AXKuhta/stm32_ad9910/README.md

# stm32_ad9910

A rack-mounted signal generator built around an AD9910 evaluation board and a NUCLEO-F746ZG

siggen_outside_gamma2
siggen_insides_gamma2
