AXKuhta/stm32_ad9910/Docs/box.jpg

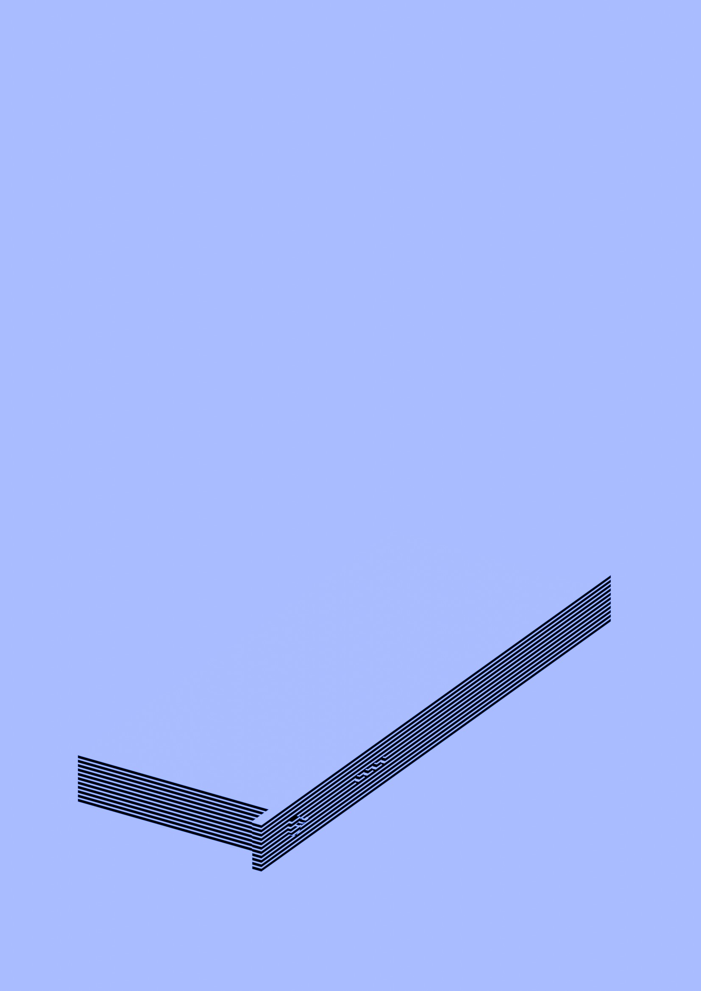
Docs/box.jpg
