AXKuhta/stm32_ad9910/(list of files, cad)

Other CAD files:
Docs/box.blend
