AXKuhta/stm32_ad9910/Docs/Images/signal_generator.drawio.pdf

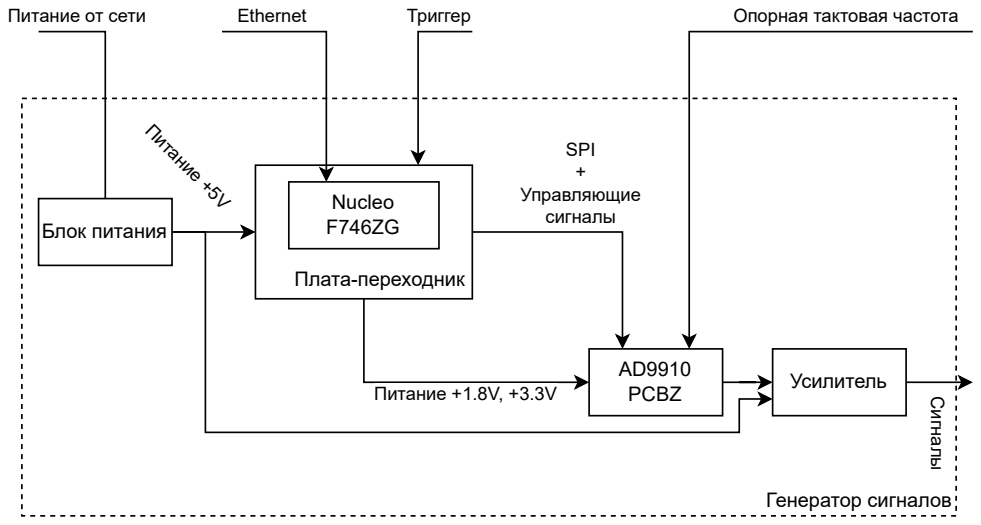
[picture p2: page 1]
Генератор сигналов; AD9910 PCBZ; Питание +5V; Триггер; Плата-переходник; SPI + Управляющие сигналы; Ethernet; Nucleo F746ZG; Питание +1.8V, +3.3V; Блок питания; Сигналы; Усилитель

Питание от сети

Опорная тактовая частота
