AXKuhta/stm32_ad9910/Docs/Images/physical_interfaces.drawio.pdf

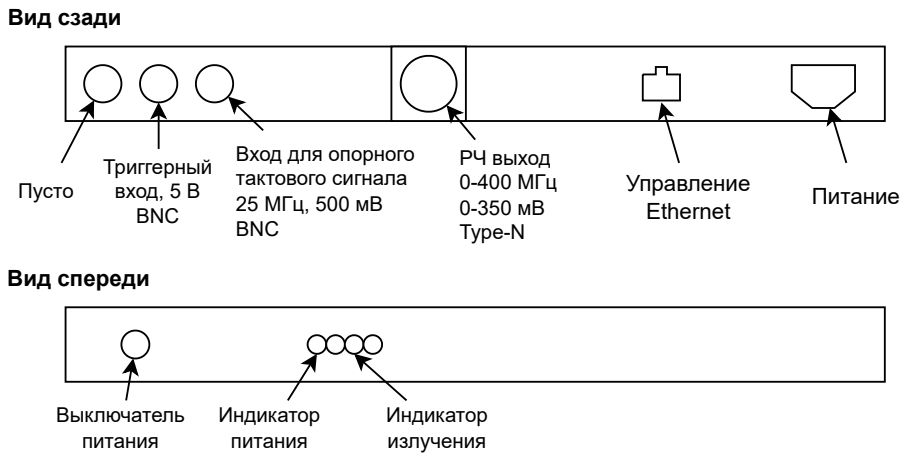
[picture p3: page 1]
Выключатель питания; Индикатор питания; Индикатор излучения; Вид спереди; Вид сзади; РЧ выход 0-400 МГц 0-350 мВ Type-N; Триггерный вход, 5 В BNC; Пусто; Управление; Ethernet; Питание

Вход для опорного
тактового сигнала
25 МГц, 500 мВ
BNC
