AXKuhta/stm32_ad9910/include/units.h

double parse_freq(double freq, const char* unit);
double parse_time(double time, const char* unit);
double parse_volts(double voltage, const char* unit);
char* time_unit(double time);
char* freq_unit(double freq);
char* volts_unit(double voltage);
