AXKuhta/stm32_ad9910/include/ad9910.h

#include "ad9910/registers.h"
#include "ad9910/profiles.h"
#include "ad9910/secondary.h"
#include "ad9910/pins.h"
#include "ad9910/drg.h"
#include "ad9910/units.h"
#include "ad9910/ram.h"
#include "ad9910/misc.h"
#include "ad9910/init.h"
