AXKuhta/stm32_ad9910/(commit log)

2022-10-29 A fresh start
    No Keil.
    Right now this is a modified uart printf example, built and flashed using a Makefile.
2022-10-29 Drop Error_Handler()
    Newlib-nano assert() works fine
    [main.c]
2022-10-29 Remove stm32f7xx_hal_msp.c and main.h
    Add uart.c + uart.h
2022-10-29 Switch to a faster UART speed (115200 bps)
2022-10-29 Print clock info on startup
2022-10-30 Interrupt profiler
2022-10-30 Receive input on USART3 using DMA
2022-11-02 Rough wiring diagram
2022-11-03 Include STM32 support code in the repo
2022-11-06 Add STM32 pin functions to wiring diagram
2022-11-06 Interrupt-based UART input
2022-11-06 Improve interrupt recorder + formatting
2022-11-11 Timer bring-up
2022-11-11 SPI bring-up
2022-11-12 Use assert() in spi.c
2022-11-12 Add SPI performance counters
2022-11-12 Initial version of mode switching
2022-11-12 Add code to print and scan floats
    Firmware size goes from 30244 B to 49028 B but overall there's still a ton of space left
2022-11-14 Remove some of the communication delay
    Right now it takes 78 ms to switch test tone frequencies
2022-11-14 Make SPI go faster
    Still at 78 ms
2022-11-14 Don't pulse IO_RESET so much
    Pulse it only on full write or full readback
    Test tone switch is now 1.9 ms
2022-11-14 Avoid printing stuff in ad_write_all()
    Delay from the first bit over SPI to signal out is now 292 us
    [ad9910.c]
2022-11-14 Mark ethernet conflict on the wiring diagram
2022-11-17 Use three separate GPIO pins to control AD9910 profiles, also place IO_UPDATE on a pin that could be controlled by a timer
2022-11-17 Use OSK pin and switch profiles using separate GPIOs
2022-11-23 Improved wiring diagram
2022-11-25 Switch from SPI1 to SPI4 as SPI1 pins conflicted with Ethernet on the board
2022-11-25 Switch from PD15 to PG9 as IO_RESET
    CN7 is free now
2022-11-25 Update wiring diagram
2022-11-25 Remove hardcoded basic_pulse parameters
    Right now 2 us appears to be the shortest pulse that it can produce. Anything shorter gets unstable.
    [uart_cli.c, units.c, units.h]
2022-11-25 Avoid rewriting timer register on the fly
    Use TIM2 CH3 to start the pulse and TIM2 CH4 to stop it
    Now it will only fail to pulse at all if target pulse duration is less than 700ns, although any pulse longer than 700ns will in reality last at least ~1500ns
    [isr.c, sequencer.c]
2022-11-25 Fix time printing in basic_pulse_cmd()
    [uart_cli.c]
2022-12-01 basic_sweep command works now (Pulse parameters still hardcoded)
    Ensure DRHOLD is tied to ground
2022-12-01 Mark DR_CTL as connected on the wiring diagram
2022-12-01 Timer values now have timing_t
2023-03-15 Adapter board support
2023-03-15 Fix sweeps
    DR_HOLD has to be tied to low.
    [ad9910.c, timer.c]
2023-03-15 Delete io_update_timer_controlled(), io_update_software_controlled() since IO_UPDATE is not timer controlled anymore
    IO_UPDATE initialization is now located in init_control_gpio()
2023-03-21 Pin assignment refactoring
    - Define pins as a PORT, NUMBER pair
    - Works as is with HAL_GPIO_WritePin() and HAL_GPIO_DeInit()
    - Doesn't work as is with HAL_GPIO_Init()
    - Introduce PIN_Init() and PIN_AF_Init() wrappers
    [ad9910.c, init.c, pin_init.h, spi.c, timer.c, uart.c]
2023-03-22 Undo the miswired profile pins workaround
    Profile pins are wired up correctly now
    [ad9910.c]
2023-03-22 Sequencer works now (for fixed frequency pulses)
    [ad9910.c, init.c, sequencer.c, sequencer.h, timer.c, uart_cli.c, vec.h]
2023-03-29 Enable timer5 as a simple time base
2023-03-29 Make timer5 triggerable via a CLI command
2023-04-04 Reorganize so that ad9910.h doesn't have to be included from vec.c
    [ad9910.c, ad9910.h, sequencer.c, sequencer.h, uart_cli.c]
2023-04-04 Fix: Phase Offset Word is 16 bit
    [sequencer.h]
2023-04-05 Fix ad_calc_ramp() for wide sweeps
    [ad9910.c]
2023-04-05 Fix ad_calc_ramp() for wide sweeps #2
    [ad9910.c]
2023-04-05 Improve interrupt recorder; avoid performing an O(n) list traversal from inside an interrupt handler
    [isr.c]
2023-04-05 Proof-of-concept FSK signal at 9600 bps using interrupts
    Jitter is 100-150ns at the first transition
    [isr.c, timer.c, uart_cli.c]
2023-04-05 Whoops, RCC_TIMPRES_ACTIVATED is used to enable 216 MHz on timers, not RCC_TIMPRES_DESACTIVATED
2023-04-05 FSK proof-of-concept: synchronize the start correctly
    [isr.c]
2023-04-11 Improve vec.h (the dynamic array) again
    It now looks like this:
    ```
    vec_t(int)* sequence = init_vec(int);
    vec_push(sequence, 1);
    vec_push(sequence, 2);
    vec_push(sequence, 3);
    ```
    Push chaining works:
    ```
    printf("%d\n", vec_push(sequence, 6)) => 6
    ```
    No idea why would you want to do that, but it works.
2023-04-12 Fix the sequencer
    It didn't set the default modulation buffer in sequencer_run()
    Drop duplicate code form sequencer_run(), make it rely on pulse_complete_callback()
    [sequencer.c]
2023-04-12 Fix ad_calc_ramp() again
    Previously broken by adjusting it to work with a TIM2 that ran too slow
    [ad9910.c]
2023-04-12 Fix argument count checks in xmitdata_fsk_command()
    Also use double for data rate to allow data rates like 0.5 Hz
    Sample command:
    basic_xmitdata fsk 0 us 150.00 MHz 150.01 MHz 9600 Hz 1 1 0 1
    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
    [uart_cli.c]
2023-04-12 Load data into vec_t in xmitdata_fsk_cmd()
    It will leak memory. Not sure where to place the vec_free() right now.
    [uart_cli.c]
2023-04-12 Drop datatest_cmd(), add verification prints to xmitdata_fsk_cmd()
2023-04-12 xmitdata_fsk_cmd() works
    Doesn't repeat the packet, although it should
    basic_xmitdata fsk 0 us 1 ms 150.00 MHz 150.01 MHz 9600 1 1 0 1 1 1 0 0 0 1
    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
    [uart_cli.c]
2023-04-12 Bump up uart input buffer to 256 bytes
    Allows copypasting longer commands
2023-04-12 Relocate timer5_restart() away from uart_cli.c
2023-04-12 Fix: default modulation buffer (That always transmits profile 1) has a size of one, not zero!
    [sequencer.c]
2023-04-12 Fix a lag after the first pulse
    I think timer2_restart() erased the values written in pulse_complete_callback()
    [sequencer.c]
2023-04-12 Reduce spectral splatter in xmitdata_fsk_cmd()
    Hamming distance between profiles 1 and 2 is two bits, and GPIO writes in set_profile() are not
    instant, so it briefly (~25 ns) sits at a wrong 0 MHz profile, making a messy signal.
    Use profiles 2 + 3, which are one bit apart.
    basic_xmitdata fsk 0 us 900 ms 51.0 MHz 51.0 MHz 9600 2 3
    Should produce the same thing as:
    basic_pulse 0 us 900 ms 51.0 MHz
    Given that phase autoclear on AD9910 is disabled.
    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
    [uart_cli.c]
2023-04-18 Looks like tio doesn't need sudo when a valid device is specified
2023-04-18 Reintroduce USART3 RX DMA
2023-04-19 Drop debug prints related to USART3
2023-04-19 So it looks like TIM5 IRQ handler may fire even after the IRQ was disabled
    Account for that by switching the modulation buffer
2023-04-19 Trigger TIM5 from TIM2 without involving the ARM core
    Jitter at first transition: ~125 ns -> ~75 ns
    [isr.c, timer.c]
2023-04-19 Shorten xmitdata_fsk_cmd() by breaking out the vec(uint8_t) scan into scan_uint8_data() which can also be reused
    [uart_cli.c]
2023-04-19 PSK modulation works
    basic_xmitdata psk 0 us 1 ms 11.10 MHz 9600 2 3
    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
2023-06-14 Use LL_GPIO_WriteOutputPort() to switch profiles
    This is bugged at the moment:
    - If hamming distance between profiles is > 1, AD9910 will occasionaly miss some of the bits
    - Thus, a wrong profile may be set
    Avoid switching more than one bit at a time.
    [ad9910.c]
2023-06-14 Readability improvement:
    Note about DMA:
    DMA1, which can be triggered from TIM5, can't write to GPIOs
    TIM8 + DMA2 must be used instead
    How to start DMA:
    HAL_DMA_Start_IT(&dma_tim_update, (uint32_t)buf, (uint32_t)&GPIOD->ODR, 4);
    __HAL_TIM_ENABLE_DMA(&timer, TIM_DMA_UPDATE);
2023-06-14 Switch from TIM5 to TIM8
    Untested, no hardware at hand
2023-06-14 Simplify timer_mu(), add rounding
    Hope I didn't break it
    Right now all constants are doubles, but the FPU here supports only floats
    This code is not performance critical so leave it like that
    Also lrint() should be used for rounding but it looks like it doesn't get inlined on ARM
    [timer.c]
2023-06-15 Dial in modulation timer to be almost perfect
    Oscilloscope shows 9.59998 KHz
2023-06-15 Reintroduce TIM8 debug output silencing when outside a pulse
    Also clean up timer.h
2023-06-15 DMA sort of working
    NDTR counter gradually goes down
    HAL_DMA_Start() does nothing if it detects that DMA is busy, i.e. active
2023-06-15 Switch to HAL_DMA_Start_IT()
    The interrupt appears to fire two situations:
    - When the buffer ran out
    - When transitioning from "ready" to "busy"
    HAL_DMA_IRQHandler() will reset completed DMAs
    [sequencer.c]
2023-06-15 Use __HAL_TIM_ENABLE_DMA() at the start of the pulse, __HAL_TIM_DISABLE_DMA() at the end of the pulse
    Seems to work well but still missing the 0-th element in the modulation sequence currently
    [isr.c, sequencer.c, timer.c]
2023-06-15 DMA is now able to start the pulse at the correct time. Actual modulation currently broken.
    When triggered on the falling edge of EXT_TRIG:
    Jitter: ~5 ns
    Delay: 150 ns
    [isr.c, sequencer.c, timer.c]
2023-06-15 DMA + Modulation works (hardcoded to 20 elements for now)
    Unfortunately, it looks like DMA will just latch the value if MINC is disabled -- the value can't be changed later on in the transfer
    MINC has to be enabled and the source buffer has to be fully populated
2023-06-15 Leave TIM8_UP_TIM13_IRQn permanently enabled, it won't fire unless TIM8 is running
    [isr.c, timer.c]
2023-06-18 Silence some warnings found in STM32 HAL code
2023-06-20 Run DMA in circular mode directly from the array in seq_entry_t
2023-06-20 Run TIM8 and DMA2 in no interrupt mode
2023-06-20 Add some missing set functions to ad9910.c
    [ad9910.c]
2023-06-22 Store modulation time step in seq_entry_t, add modulation timer reconfiguration, calculate total pulse duration automatically in xmitdata_fsk_cmd() and xmitdata_psk_cmd()
    basic_xmitdata fsk 0 us 151 MHz 51 MHz 1 us 2 3 2 3 2 3 2 3 2 3 2 3 2 3 2 3 0
    Tailing zero is for a cleaner signal termination
    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
2023-06-22 Work around some occasional start failures
    I think pulse_t1_pass became desynced for some reason
    [isr.c, sequencer.c]
2023-06-22 Get rid of pulse_t1_pass altogether
    There was no need to write 0xFFFF into TIM8->CCR1 (to silence the debug output) since I was disabling the entire timer anyway.
    With no 0xFFFF in there, there is also no need to restore the original CCR1 value.
    Thus the entire pulse_t1_pass == 0 code path can be deleted and its interrupt source (TIM2 CH3) can be disabled.
2023-06-22 Prevent modulation debug output from occasinally staying high
    [isr.c]
2023-06-22 Trigger TIM8 from TIM2 CH3 specifically
    Switch TIM2 CH3 to PWM2 from TOGGLE (Toggle worked too but it skipped half of EXT TRIGs)
    [timer.c]
2023-06-22 Throw errors in xmitdata_fsk_cmd(), xmitdata_psk_cmd() if tstep is too large to fit into a 16 bit timer
    [uart_cli.c]
2023-06-22 Fix comparisons in xmitdata_fsk_cmd(), xmitdata_psk_cmd()
    They were asserts previously, and I forgot to change < to >= when rewriting them as if statements
    [uart_cli.c]
2023-06-26 Add modulation debug output to wiring diagram
2023-06-26 Fix datatype for %n in sscanf, it should always be int
    Using size_t works on STM32 which is 32 bit, but it will break on 64 bit x86_64
    [uart_cli.c]
2023-06-27 Fix pulses with offset == 0, been broken since f4b0cfeabf
    [sequencer.c, timer.c]
2023-06-27 Update debug_print_entry() to support RAM profiles
    Previously it printed garbage on RAM profiles
2023-06-27 Remove hardcoded RAM profile mode, allow changing it
    I have a suspicion that zero-crossing mode is bugged
    [ad9910.c, ad9910.h, sequencer.c, uart_cli.c]
2023-06-29 Improve debug_print_entry() in sequencer
    It now prints human-readable frequencies
2023-06-29 If available, print AD9910 RAM images in `seq show`
2023-06-29 Add profile modulation buffer printing to `seq show`
2023-06-29 Print t1 and t2 in human-readable units in `seq show`
2023-07-01 Remove platform-dependent code from uart_cli.c
2023-07-01 Fix standalone compilation of uart_cli.c
    gcc -D"STANDALONE_CLI_APP" -I"include/" -c uart_cli.c
    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
    [uart_cli.c]
2023-07-04 Move AD9910 pin control into ad9910/pins.c
2023-07-04 Move AD9910 misc functions (SYNC_CLK toggle and phase reset drop) into ad9910/misc.c
    [ad9910.c, ad9910.h]
2023-07-04 Fix warnings 2/2
    Testing results: nothing looks broken
    [pins.c]
2023-07-04 Turn timer_mu, timer_ns into macros since they are simple enough
2023-07-04 Fix timer_mu, timer_ns macros
    Macro args have to be wrapped in brackets to avoid precedence problems
2023-07-04 Fix standalone CLI for modular ad9910 driver
2023-07-05 Add sweep configuration printing to `seq show`
2023-07-05 Allow changing AD9910 PLL charge pump current
    0, 1 = Loses PLL lock when switching frequencies
    2 an up = Seems to be OK
2023-07-05 Drop unused prototypes from ad9910/profiles.h
2023-07-06 vec.h: allow declaring multiple vec_t's of same type inside a function
    Didn't notice up until now that the compiler does not allow duplicate struct names:
    void f() {
    struct ab_t { int a, b; } x;
    struct ab_t { int a, b; } y; // Redefinition of struct ab_t
    }
    Unnamed structs help:
    void f() {
    struct { int a, b; } x;
    struct { int a, b; } y;
    }
    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
    [vec.h]
2023-07-06 Add a dedicated RAM-only `basic_xmitdata ram_psk`
    It constructs a new RAM image for a given sequence.
    Has much reduced jitter when switching phase, since profile pins are not used.
    However, it is limited to 1023 element sequences instead of 65535 when using DMA + profile pins.
    [uart_cli.c]
2023-07-06 Reduce tail jitter in `basic_xmitdata ram_psk` by extending the ramp up sequence with one more element that has 0 amplitude
    The first peak looks kind of bent on the oscilloscope... Does not happen with `basic_xmitdata psk`. Not sure what's happening here.
    [uart_cli.c]
2023-07-06 This is strange! Enabling RAM later on seems to fix the bent first peak
    [sequencer.c]
2023-07-06 Drop ad_enable_ram(), ad_disable_ram()
    RAM is always enabled on AD9910 and a more appropriate name for this bit is "RAM playback enable"
    Enable RAM playback along with phase static reset drop
    [ram.c, sequencer.c]
2023-07-18 FreeRTOS seems to work in some capacity
    Two tasks printing AAA and BBB at 1s intervals, indeed print.
    Needs config from:
    https://github.com/STMicroelectronics/STM32CubeF7/blob/master/Projects/STM32F746ZG-Nucleo/Applications/LwIP/LwIP_HTTP_Server_Netconn_RTOS/Inc/FreeRTOSConfig.h
    And malloc/free adapter from:
    https://nadler.com/embedded/newlibAndFreeRTOS.html
2023-07-18 Bundle some FreeRTOS-related parts
    Add FreeRTOSConfig.h derived from:
    https://github.com/FreeRTOS/FreeRTOS/blob/main/FreeRTOS/Demo/CORTEX_M4F_STM32F407ZG-SK/FreeRTOSConfig.h
    Add malloc/free adapter taken from:
    https://github.com/DRNadler/FreeRTOS_helpers
    Place FreeRTOS-facing code in freertos/
    Avoid renaming functions using #define, just call them, LTO will inline it
    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
    [isr.c]
2023-07-19 Start FreeRTOS early, init hardware from an init thread
    CLI works, sequencer not quite
    Edit: CLI unrealiable, may freeze
2023-07-19 FreeRTOS ported!
    - Drop my DIY task scheduler, but leave add_task()
    - FreeRTOS tasks can't be spawned from interrupts
    - Instead, a queue of pending void f(void) function calls is kept
    - Assign lower priority to TIM2 and USART3 interrupts (>configLIBRARY_MAX_SYSCALL_INTERRUPT_PRIORITY) such that they can use FreeRTOS queues to push "tasks"
    My DIY scheduler had a race condition that went unnoticed up until now:
    - run_all_tasks() could be interrupted at any point in time, possibly inbetween it exiting the for loop and zeroing tasks_pending
    - This interrupt could add a new task, but it would be lost
    - Sleeping with WFI masked this problem because it would ensure that run_all_tasks() gets run af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
    [main.c, timer.c, uart.c]
2023-07-20 Enable configIDLE_SHOULD_YIELD
    Tickless idle does not quite work, hard faults after a context switch following any command
2023-07-20 Pin FreeRTOS kernel version to V10.6.0
2023-09-28 Ethernet bring-up: drop files conflicting with FreeRTOS-Plus-TCP
    FreeRTOS-Plus-TCP bundles a custom stm32f7xx_hal_eth.c + stm32f7xx_hal_eth.h
    https://github.com/FreeRTOS/FreeRTOS-Plus-TCP/blob/main/source/portable/NetworkInterface/STM32Fxx/readme.md
2023-09-28 Ethernet bring-up: update FreeRTOSIPConfig.h with settings recommended for STM32F7
    Silences one warning:
    FreeRTOS-Plus-TCP/source/portable/NetworkInterface/STM32Fxx/NetworkInterface.c:99:10: warning: #warning Consider enabling checksum offloading
2023-10-03 Ethernet bring-up: update packet size config and linker script in accordance with https://github.com/FreeRTOS/FreeRTOS-Plus-TCP/blob/main/source/portable/NetworkInterface/STM32Fxx/readme.md
2023-10-03 Ethernet bring-up: ethernet seems to work in some capacity, but something hard faults when deferred_daemon_run_all() is uncommented
2023-10-03 Disable DHCP, DNS, use a fixed IP, count ethernet interrupts
    [isr.c, main.c]
2023-10-12 Fix the overall system weirdness that resulted from having xPortPendSVHandler(), which is a naked function, wrapped in a normal function
    I love shooting myself in the knees
    Ethernet still doesn't seem to work right while LTO is enabled, it's like it can't send/receive reliably, just a few pings here get a reply
    [isr.c, main.c]
2023-10-15 Properly warn about interrupt recorder index collision
    The print was missing an \n and wasn't getting flushed
    [isr.c]
2023-10-15 Avoid collisions by shrinking the list size a bit
    [isr.c]
2023-10-15 Fix a crash in parse()
    [uart.c]
2023-10-15 Implement HAL_UART_ErrorCallback
    Actually triggerable (surprisingly, from DMA1_Stream1_IRQHandler) when looking at UART interrupts via gdb:
    (gdb) br HAL_UARTEx_RxEventCallback
    Breakpoint 1 at 0x80052f4: file uart.c, line 112.
    Note: automatically using hardware breakpoints for read-only addresses.
    (gdb) command 1
    Type commands for breakpoint(s) 1, one per line.
    End with a line saying just "end".
    >print usart3.RxXferCount
    >cont
    >end
    (gdb) run
    DMA is acting strange: IDLE interrupts fire as expected, DMA status is READY, but data only appears in memory after a while.
    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
2023-10-17 Fix brokenness of USART3 receive DMA that developed after FreeRTOS-Plus-TCP was added into the build.
    Here's what I think happened:
    - Previously, input_buffer was located in the first 64 KB of RAM which is uncached
    - Later, FreeRTOS-Plus-TCP was added which keeps its ethernet buffers statically allocated in the first 64 KB of RAM
    - So input_buffer was now located somewhere in cached RAM (I just checked, it's located at 0x20016be0 now)
    - DMA does not update ARM d-cache
    - The code was reading stale values (zeroes) from d-cache
    The cache must be invalidated first:
    https://community.st.com/t5/stm32-mcus-products/maintaining-cpu-data-cache-coherence-for-dma-buffers/td-p/95746
    There's also errat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
    [uart.c]
2023-10-17 Drop unused code, fix a comment
    We're back in a working state, it looks like.
    [main.c, sequencer.c]
2023-10-26 Wait no longer than 15 seconds for socket shutdown to take effect
    Timeout of recv() is determined by ipconfigSOCK_DEFAULT_RECEIVE_BLOCK_TIME
    [server.c]
2023-10-29 Leave the Cortex-M7 cache disabled as it was causing Ethernet unreliability
    Ethernet somewhat worked but went unresponsive for random periods of time and occasionally corrupted packets.
    Works perfectly now, 0% packet loss.
    No idea what was happening; something not invalidated correctly or did I actually hit erratum 1259864?
    [init.c]
2023-10-29 Fix _write() calls in uart.c to write into 1 (stdout) instead of 0 (stdin)
    Not that there is any difference given the current implementation of _write()
    [uart.c]
2023-10-29 Server: spawn a separate task to handle a client
    vTaskDelete(NULL); must be used to exit the task, and stdout/stderr/stdin need to be closed to prevent newlib from leaking memory
    [server.c]
2023-11-08 Fix redownload_stm32_support_code.sh
    ST switched to using submodules on master, so download the final tag that didn't use submodules
2023-11-08 Fix build
    The fact that it didn't build (with a clean copy of FreeRTOS-Plus-TCP) went unnoticed because I had an untracked copy of FreeRTOS-Plus-TCP with some modifications in it
    [isr.c]
2023-11-08 Implement printf() while bypassing the picolibc stream infrastructure
    Builds, but does it work?
2023-11-09 Smarter "hashing" in interrupt recorder
    All __FUNCTION__ strings seem to always have their two lowest bits zero:
    (gdb) print &'__FUNCTION__.0'
    $16 = (<data variable, no debug info> *) 0x8012cac <__FUNCTION__.0>
    (gdb) print &'__FUNCTION__.1'
    $17 = (<data variable, no debug info> *) 0x8012c90 <__FUNCTION__.1>
    (gdb) print &'__FUNCTION__.2'
    $18 = (<data variable, no debug info> *) 0x8012cbc <__FUNCTION__.2>
    (gdb) print &'__FUNCTION__.3'
    $19 = (<data variable, no debug info> *) 0x8012c78 <__FUNCTION__.3>
    (gdb) print &'__FUNCTION__.4'
    $20 = (<data variable, no debug info> *) 0x8012c60 <__FUNCTION__.4>
    (gdb) print &'__FUNCTION__.5'
    $21 = (<data variable, no debug info> *) 0x8012cdc <__FUNCTION__.5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
2023-11-09 Fix puts() -- it must add a newline
    printf() can't rely on puts(), so switch to _write()
2023-11-09 Stop printf redirection when the client disconencts
2023-11-09 Switch to vasprintf(), add some comments
2023-11-14 Rename hacks.c -> printf.c now that it primarily contains code regarding printf()
2023-11-14 Fix slowness of remote control over TCP
    FREERTOS_MSG_DONTWAIT must be used when sending
    Also noticed that ipconfigTCP_RX_BUFFER_LENGTH and ipconfigTCP_TX_BUFFER_LENGTH are configured to a low value of 1000 instead of the default 5840
    RAM usage does increase by about 8KB if you set them to 5840 so I've decided to leave them at 1000 since that seems to work fine.
    [server.c]
2023-11-14 Disable ipconfigHAS_PRINTF
    Hitting a crash in memory allocator from printf in prvEthernetUpdateConfig, not sure what's causing it but not doing printf() helps
2023-11-14 Add some very basic jitter measurements
2023-11-14 Exact sweep duration
    Introduce the idea of using the AD9910 RAM to time signal duration, where a combination of RAM step duration and step count is computed that has a desired total duration
    This practically removes the duration jitter since AD9910 is not relying on the host microcontroller for duration timing. The offset jitter is still present though.
    This also makes it impossible to have certain durations, like `basic_sweep 0 us 900.05 us 152 MHz 154 MHz`, but I don't think anybody would need those anyway.
    Durations close to 900.05 us are still possible:
    basic_sweep 0 us 900.04 us 152 MHz 154 MHz
    basic_sweep 0 us 900.06 us 152 MHz 154 MHz
    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
    [algos.c, algos.h, uart_cli.c]
2023-11-23 Do not use vasprintf(); seeing freelist corruption while using it
    Freelist corruption can be checked for in gdb:
    print *xStart.pxNextFreeBlock
    Update after some debugging:
    - Freelist is corrupted early on
    - It is corrupted when printing "Radar emulator enabled: 12 us pulses at 25 Hz"
    - A 32 byte allocation is made and then overrun, as the end result is 45 bytes
    - A BlockLink_t that sat after the allocated 32 bytes is corrupted
    br pvPortMalloc
    br vPortFree
    command 1
    bt
    print *xStart.pxNextFreeBlock
    cont
    end
    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
2023-11-23 Revert "Do not use vasprintf(); seeing freelist corruption while using it"
    I figured it out! The realloc() was broken all along, it didn't account for the fact that xBlockSize stores metadata in its upper bits
    This reverts commit 287bd7352245451a01a373e02db1c06fc3829e6f.
    [printf.c]
2023-11-23 Reenable ipconfigHAS_PRINTF now that printf is not crashy
2023-12-12 Fix some glitchiness on signal start when test_tone command was used previously
    Reproduction of glitches on previous commit:
    test_tone 150 MHz
    basic_pulse 0 us 900 us 150 MHz
    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
    [sequencer.c]
2023-12-21 Implement a workaround for the fact that DRG and RAM have different pipeline latency
    Works fine for f1 < f2 sweeps
    [uart_cli.c]
2023-12-21 Fix workaround to work with f1 > f2 sweeps as well
    [uart_cli.c]
2023-12-21 Fix the lingering 180 deg start phase problem on f1 > f2 sweeps while I'm at it
    [uart_cli.c]
2024-01-23 Avoid using ad_set_profile_amplitude() to clear the upper byte of a profile register
    It clears the upper byte of RAM step rate as well, which breaks step rates >255
    That's what you call a self own
    [profiles.c, sequencer.c]
2024-01-25 Fix uart cli treating abc\r\n as two commands
    [uart.c]
2024-02-01 Rework basic_sweep command to take a center frequency and a sweep span index
    Sweep span depends on pulse length and can be computed as follows:
    fstep = 1 GHz / (2^32)
    duration = 900 us
    index = 1
    span = index * fstep * (duration / 4 ns)
    center = 157 MHz
    startf = center - span/2
    endf = center + span/2
    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
    [uart_cli.c]
2024-02-15 Separate timer.c -> { timer/emulator.c, timer/sequencing.c }
2024-03-05 Remap 0/1 to 2/3 in basic_xmitdata fsk to avoid confusion
    Internally profiles 2 and 3 are used
    [uart_cli.c]
2024-03-05 Bundle picolibc
    Taken from picolibc-1.8.5-12.3.rel1.zip (https://github.com/picolibc/picolibc/releases/download/1.8.5/picolibc-1.8.5-12.3.rel1.zip)
    Exact file path: arm-none-eabi/picolibc/arm-none-eabi/lib/thumb/v7e-m+fp/hard/libc.a
2024-03-05 Fix: bpsk_ram_image[] was short-lived if declared inside a function, switch to vec_t
    Untested, should probably delete this zc_psk mode since it never really worked anyway
    [uart_cli.c]
2024-03-05 Fix RAM image size
    [uart_cli.c]
2024-04-02 Avoid using vec_t for RAM images
    [uart_cli.c]
2024-04-02 Avoid using vec_t for profile modulation buffers
    [uart_cli.c]
2024-04-02 Avoid leaking memory in the sequencer
    [sequencer.c]
2024-04-17 Fix a stuping mistake in the wiring diagram
    PB9, PB12 were missing
2024-06-13 Print out error code on uart error
    [uart.c]
2024-06-13 Whoops, do not cast uart handle to void
2024-06-13 Precise output voltage control in mV (untested)
2024-06-14 Fix voltage control
2024-06-14 Backconvert asf, fsc into mV rms voltage in set_level
2024-06-14 Print dBm in set_level
2024-06-14 Calibrated against a PR100, predicted dBm matches actual dBm or differs by 0.1 sometimes
2024-06-20 Add Docs/CALIBRATION.md
2024-06-20 Print actual type of UART errors
    Seem to get a frame error when opening a serial port and sometimes overrun errors. But why?
    [uart.c]
2024-06-21 Improve reliability of UART esp. for automated sequences of commands
    Resume reception BEFORE blocking for echo
2024-08-19 Update wiring diagram to match the actual board
2024-08-20 Fix off-by-one error in sweep bandwidth calculations
    The code actually matches the docs now
    [uart_cli.c]
2024-08-20 Upgrade parse_freq(), parse_time() to return double
    Hope that doesn't break anything
    [units.c, units.h]
2024-09-25 Enable buffered refclk output of AD9910
    Presently wired to a shift register
2024-09-25 Use OUT = CNT >= OC output mode for radar emulator timer
    This ensures a low output when CNT = 0
    This will come in handy later
2024-10-01 Implicitly stop the sequencer before resetting it
    Fixes a crash on `seq reset` if sequencer was running
    [sequencer.c, uart_cli.c]
2024-10-15 Update for new clock configuration
    STM32's OSC_IN is now wired to AD9910's REFCLK_OUT
    At startup:
    1. STM32 starts from its HSI to run at full clock and initializes USART and SPI
    2. STM32 initializes AD9910 to enable REFCLK_OUT
    3. STM32 switches to HSE
    STM32 then initializes the rest of its peripherals
2024-10-15 Avoid hardcoded frequency values in timer calculations
    Rely on HAL_RCC_GetSysClockFreq()
    [emulator.c, sequencing.c, timer.c, uart_cli.c]
2024-10-19 Add Docs/wiring_diagram_v2.drawio, a wishlist for an improved board
2025-02-07 Switch from TIM1 (Pin E9) to TIM14 (Pin F9) for radar emulator
    TIM14's repetition counter is too narrow (8 bits) so use interrupts to count remaining pulses
    [emulator.c, init.c, isr.c]
2025-02-07 Update wiring_diagram_v2.drawio with TIM14 to TIM2 arrow
2025-02-07 Some fixes to logic of TIM14 (untested)
    [emulator.c]
2025-02-10 Fixes to TIM14 pulse generator
    [emulator.c]
2025-02-10 Fix TIM14 for good
    Using the preload register should afford us one full pulse period of latency instead of a potentially very small window while CNT < OC
    [emulator.c]
2025-02-10 Wiring diagram V2: move P_2, IO_UPDATE to PD14, PD15, making them contiguous in address space
    TIM4 CH1 PD12 P_0
    TIM4 CH2 PD13 P_1
    TIM4 CH3 PD14 P_2
    TIM4 CH4 PD15 IO_UPDATE
2025-02-16 Timed logic level sequence output with DMA
    Presently missing:
    - An established method of constructing logic_level_sequence_t
    - Implementations of common signals
    [dma.c, init.c, isr.c, sequencer.c, sequencer.h, sequencing.c, uart_cli.c]
2025-02-17 Switch to a 25 MHz clock provided by AD9910
    Seeing fairly solid 1/0 logic level sequences
2025-02-17 Wire up hold time control, switch to downcounting mode so that OC registers can remain the same
2025-02-18 Fixes to logic blaster
    - Handle that a timer's DMA request may remain asserted after a pulse
    - Fix the tailing element to be 1 us not .1 us
    [sequencer.c, uart_cli.c]
2025-02-18 Fix pin mappings and verify on the current board
    Bodge wires required:
    PD14 -> PD11
    PD13 -> P_0 (Was cut earlier)
    [pins.c, uart_cli.c]
2025-02-18 Fix numerics of lower_logic_sequence() by using plain nanoseconds
    [uart_cli.c]
2025-02-19 Fail gracefully in sequencer_run() when sequencer is empty
    [sequencer.c]
2025-03-03 Fix cold start failures
    The cause:
    - IO_UPDATE pulse was too short
    Test procedure:
    - Reset the AD9910 by lifting its master reset
    - Reseat master reset
    - Attempt to reset the STM32
    [drg.c, init.c, pins.c, sequencer.c]
2025-03-03 Avoid calling printf to display printf errors - causes a loop
    Return -1 from printf in case of errors
    Handle client disconnect in `wait`
    [printf.c, server.c, uart_cli.c]
2025-03-03 Fix a memory leak in printf
    Yeah
    [printf.c]
2025-03-06 Attempt to use TIM2 as a free-running timer with its channel 1 used to capture trigger times
    Doesn't work right, slave timers are enabled once and cant seem to be disabled ever again
    [dma.c, isr.c, sequencer.c, sequencing.c]
2025-03-07 Fix stop interrupt detection in DMA handler - look at NDTR!
    [isr.c]
2025-03-07 Semi-fix for pulse happening 8ms late - not fully fixed yet
    Runs properly for ~10s, then wigs out, then repeats
    [isr.c, sequencer.c]
2025-03-07 Prevent pulse_complete_callback() before pulse is, in fact, complete
    Specifically, prevent NDTR reaching zero until the pulse is over
    Wrongfully assumed that this was the case earlier
    Seems to fix the random extra delay
    [uart_cli.c]
2025-03-07 Fix comment
    - Delay support
    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
    [uart_cli.c]
2025-03-11 Fix a dumb typo (DMA_CHANNEL_1 -> TIM_CHANNEL_1)
    Should've used assert(... == HAL_OK)
    [sequencing.c]
2025-03-12 Add missing trigger counter
    [uart_cli.c]
2025-03-17 Server: remove extraneous printf unredirect
2025-03-17 Introducing the v2 sequencer interface
    - Tightly coupled to the hardware
    - Directly exposes key AD9910 registers
    - Allows specifying logic level sequence for control pins
    - Allows much more fine grained control
    - Enables flexible signal structures
    A new `seq json ...` command takes a JSON payload:
    {"v2":{
    "profiles": [
    {"asf": 0, "ftw": 0, "pow": 0},
    {"asf": 8192, "ftw": 644245094, "pow": 0}
    ],
    "logic_level_sequence": [
    {"hold_ns": 900000, "state": 16}
    ]
    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
    [json.c, uart_cli.c]
2025-03-17 Fix: we do allow 8 profiles in JSON payload
    [uart_cli.c]
2025-04-02 Using a different SWD adapter now - update Makefile
    Onboard stlink is inaccessible now that the board is inside an enclosure
2025-04-02 Adjust for 12.5 ohm load on AD9910 outputs and temporarily reset the calibration factor
    [algos.c, uart_cli.c, units.c, units.h]
2025-04-09 Docs: update wiring diagram
2025-04-10 Add front panel LED support
2025-04-10 Fix comment about pin allocation
    [sequencing.c]
2025-04-15 Some means of fighting memory fragmentation
    The fragmentation is fixed but there does appear to be a leak somewhere
    [sequencer.c, uart_cli.c]
2025-04-15 Found the memory leak! Early return strikes again
    [server.c]
2025-04-18 Enable Clock Security System
    Triggers a reset if external clock fails
    [init.c, isr.c]
2025-04-18 Survive through external clock failures
    [init.c]
2025-04-18 Add trigger polarity switch
2025-06-27 New Docs/
    Bundle eisvogel (sans examples) from https://github.com/Wandmalfarbe/pandoc-latex-template/releases/tag/v3.2.0
    [box.blend]
2026-03-24 Re-add + update the wiring diagram
2026-10-27 Fixes for v1.2 board; boots but doesn't make signals yet
2026-10-28 Fix chirps on v1.2 board
